osnapus/OpenDCF/images/schematic.png

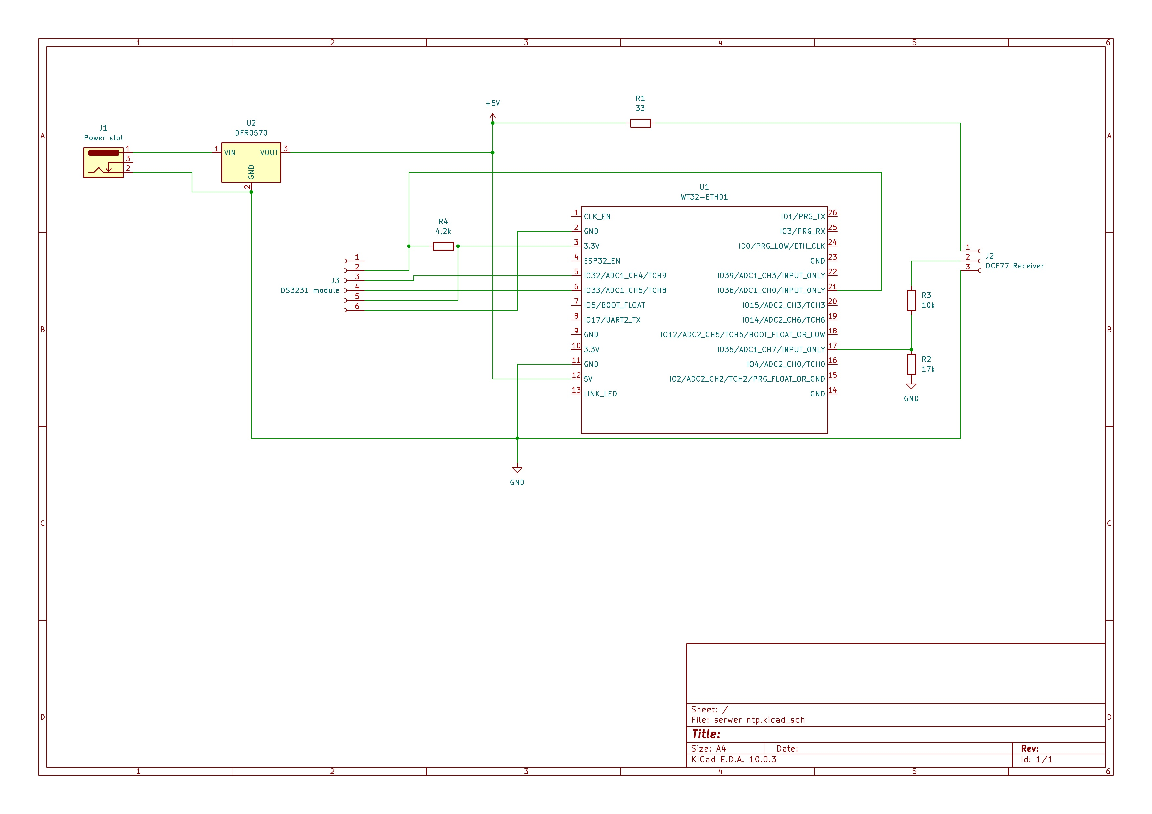
images/schematic.png
