osnapus/OpenDCF/(commit log)

2026-07-26 Update README with optional LCD display details
    Added optional I2C 1602 LCD display information to the README.
2026-07-26 Fix prototype image filename in README
    Updated image reference for the OpenDCF prototype in README.
