osnapus/OpenDCF/(notices)

Notices in the files:
README.md:
License: MIT
